gou-th/ai-core/apps/lunarlander/constrs_1/ai_core_constraints.xdc

## Clock
set_property PACKAGE_PIN W5 [get_ports clk]
set_property IOSTANDARD LVCMOS33 [get_ports clk]
create_clock -period 10.000 -name sys_clk [get_ports clk]

## Reset
set_property PACKAGE_PIN U18 [get_ports rst_n_btn]
set_property IOSTANDARD LVCMOS33 [get_ports rst_n_btn]

## UART receive
set_property PACKAGE_PIN B18 [get_ports rx]
set_property IOSTANDARD LVCMOS33 [get_ports rx]

## UART transmit
set_property PACKAGE_PIN A18 [get_ports tx]
set_property IOSTANDARD LVCMOS33 [get_ports tx]

## 7-segment display
set_property PACKAGE_PIN W7  [get_ports {seg[0]}]
set_property PACKAGE_PIN W6  [get_ports {seg[1]}]
set_property PACKAGE_PIN U8  [get_ports {seg[2]}]
set_property PACKAGE_PIN V8  [get_ports {seg[3]}]
set_property PACKAGE_PIN U5  [get_ports {seg[4]}]
set_property PACKAGE_PIN V5  [get_ports {seg[5]}]
set_property PACKAGE_PIN U7  [get_ports {seg[6]}]

set_property PACKAGE_PIN U2 [get_ports {an[0]}]
set_property PACKAGE_PIN U4 [get_ports {an[1]}]
set_property PACKAGE_PIN V4 [get_ports {an[2]}]
set_property PACKAGE_PIN W4 [get_ports {an[3]}]

set_property IOSTANDARD LVCMOS33 [get_ports seg*]
set_property IOSTANDARD LVCMOS33 [get_ports an*]
