gou-th/ai-core/apps/lunarlander/top/program.asm

LI R1, 32
LI R3, 0
LI R5, 3
LI R6, 0

L0_OUTER:
LI R2, 3
LI R4, 0

L0_INNER:
M_LD_W R3
M_LD_A R4
M_MUL R0, R0
ADDI R3, R3, 1
ADDI R4, R4, 1
LOOP R2, L0_INNER
ACT R5
ADDI R5, R5, 1

M_ST R6
ADDI R6, R6, 1
LOOP R1, L0_OUTER

LI R1, 32
LI R3, 96
LI R5, 36
LI R6, 32

L1_OUTER:
LI R2, 33
LI R4, 3

L1_INNER:
M_LD_W R3
M_LD_A R4
M_MUL R0, R0
ADDI R3, R3, 1
ADDI R4, R4, 1
LOOP R2, L1_INNER
ACT R5
ADDI R5, R5, 1

M_ST R6
ADDI R6, R6, 1
LOOP R1, L1_OUTER

LI R1, 1
LI R3, 1152
LI R5, 69
LI R6, 64

L2_OUTER:
LI R2, 33
LI R4, 36

L2_INNER:
M_LD_W R3
M_LD_A R4
M_MUL R0, R0
ADDI R3, R3, 1
ADDI R4, R4, 1
LOOP R2, L2_INNER

M_ST R6
ADDI R6, R6, 1
LOOP R1, L2_OUTER
HALT
