gou-th/ai-core/(commit log)

2026-06-07 Software foundation: ISA, assembler, NumPy golden model
2026-06-24 Added gitignore; updating assembler, golden model & docs
2026-07-01 Add 3-stage verified scalar CPU and reorganized whole folder into per module src/sim
2026-08-22 switch skew/deskew/systolic_array Makefiles to Verilator. Icarus 11.0 fails to propagate unpacked array ports across module hierarchy.Added mxu_integration module and all 3 verified & re-verified und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
2026-08-27 Implemented CPU - MXU handshake and Matrix instructions support. Added mxu_controller.sv and verified. Added cocotb testbenches for controller and end-to-end CPU-MXU flow. Updated to new .asm and .me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
2026-09-01 CPU pipeline verified end to end with BRAM memory. Added requant.sv for ReLU and fixed point multiply shift. Wired ACT instruction. Generated weights.mem and image.mem using gen_test_vectors.py for t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
    [cpu.sv, requant.sv]
2026-09-01 M_ST/ACT take destination address from Rs1, not Imm and modified assembler.py accordingly
2026-09-05 Argmax, 7 segment display and wrapper module added and verified. ai_core_top wires cpu -> argmax -> seven_seg.
2026-09-14 Pre loaded image input via UART and did live inference on Basys 3 uart_rx.sv: 115200 baud receiver with two-flop synchroniser. Modified ai_cor_top and cpu.sv for for byte to word packer and external 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
2026-09-19 Added uart_tx to Lunarlander to send the predicted action back
